Abhinavkrishna3211/Sloth-Clock/hardware/sloth_clock.pdf

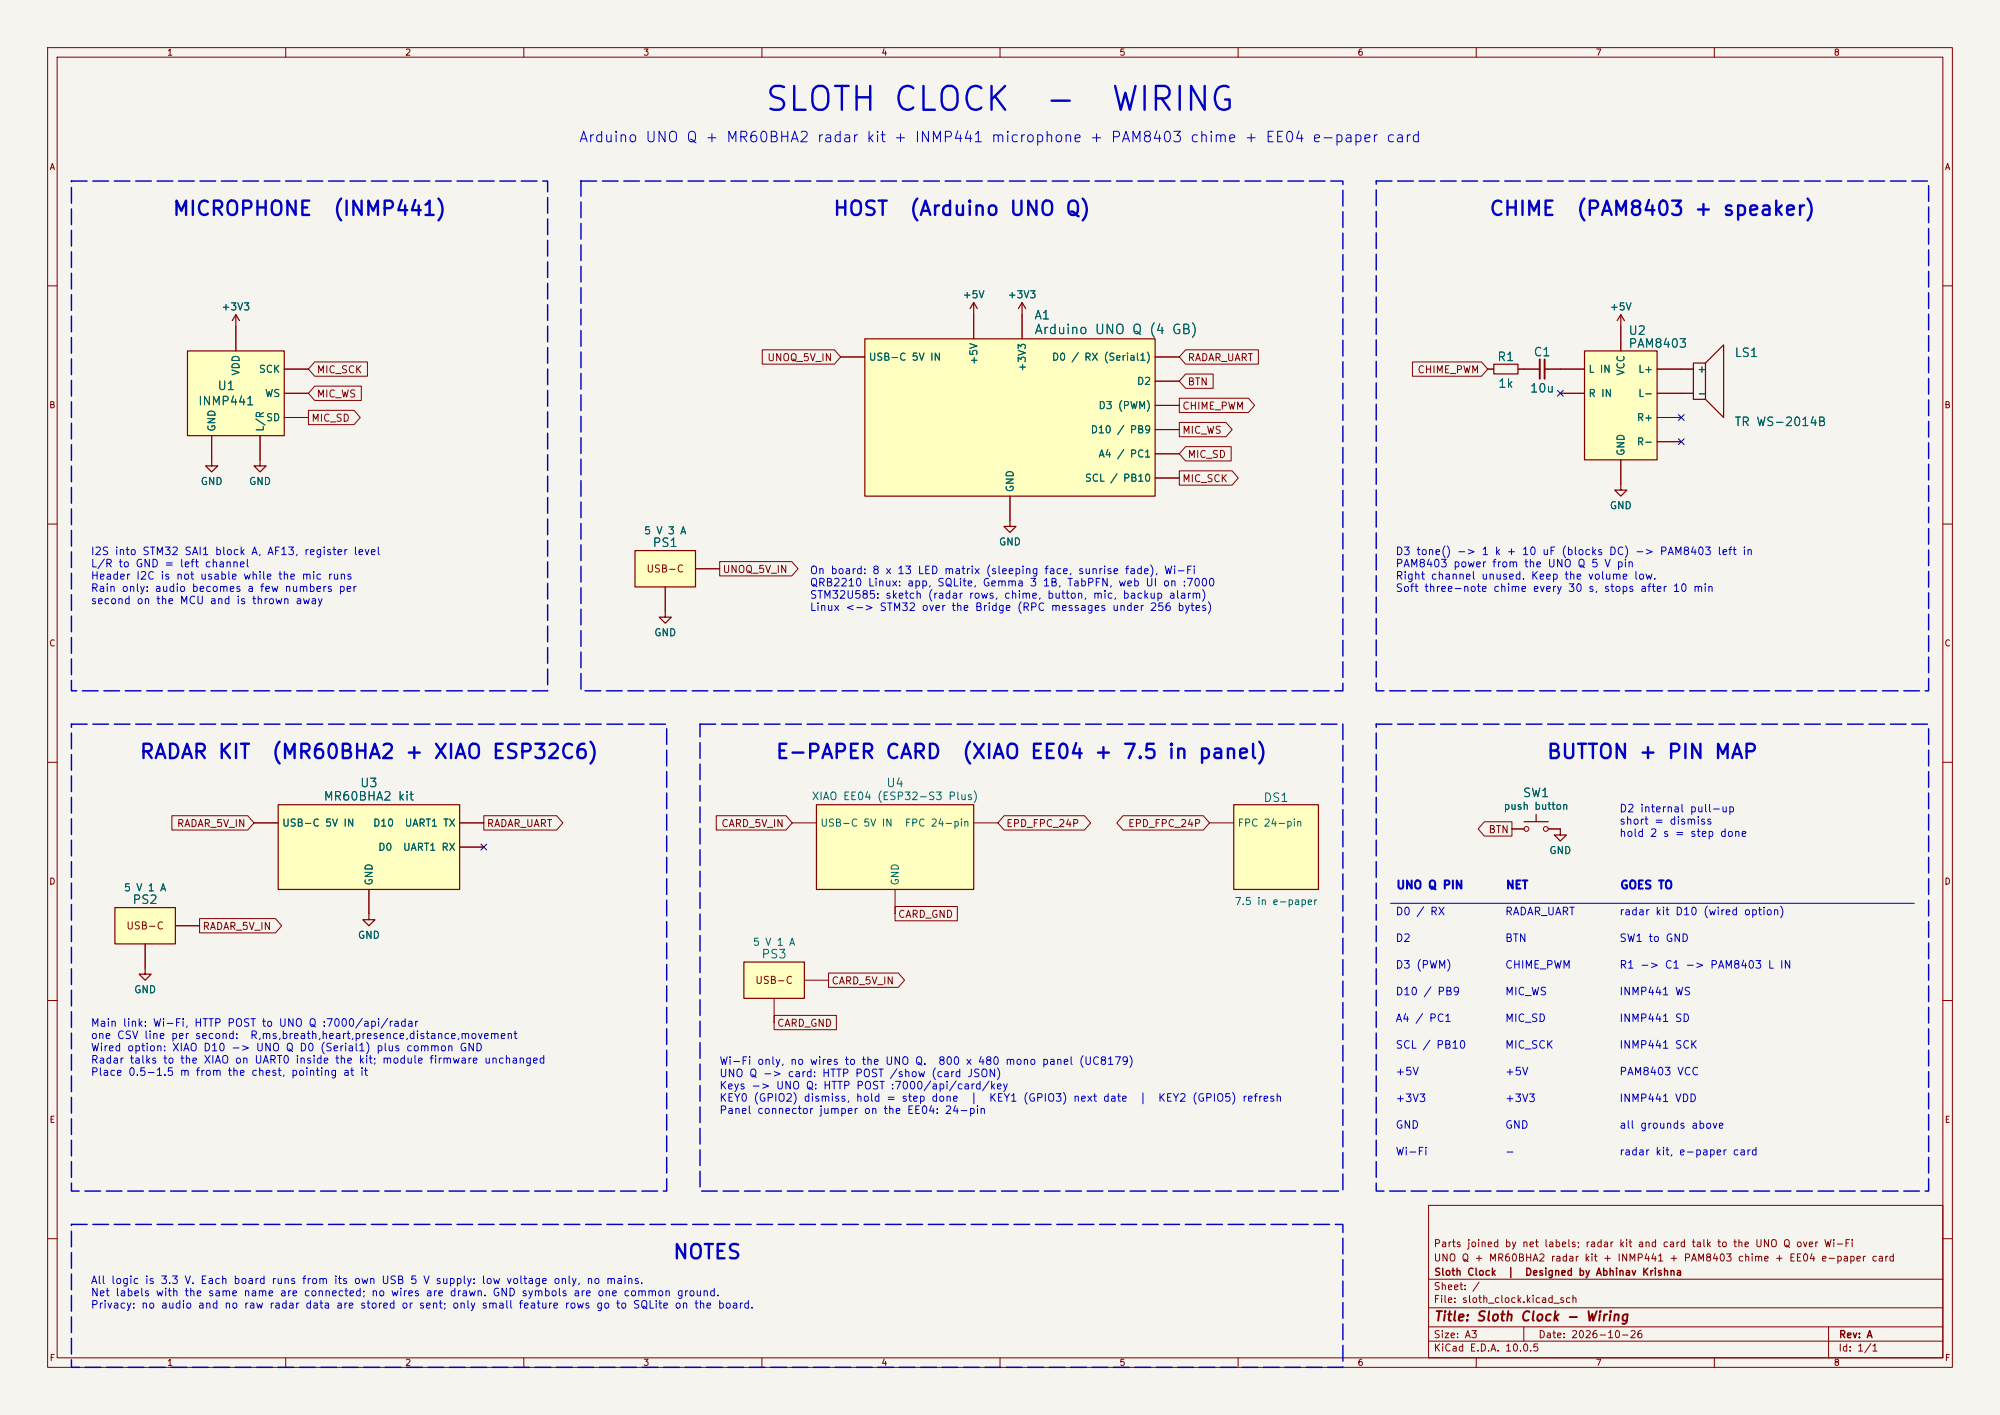
[picture p2: page 1]

Arduino UNO Q + MR60BHA2 radar kit + INMP441 microphone + PAM8403 chime + EE04 e-paper card

I2S into STM32 SAI1 block A, AF13, register level
L/R to GND = left channel
Header I2C is not usable while the mic runs Rain only: audio becomes a few numbers per

D3 tone() -> 1 k + 10 uF (blocks DC) -> PAM8403 left in
PAM8403 power from the UNO Q 5 V pin
Right channel unused. Keep the volume low.
Soft three-note chime every 30 s, stops after 10 min

On board: 8 x 13 LED matrix (sleeping face, sunrise fade), Wi-Fi
QRB2210 Linux: app, SQLite, Gemma 3 1B, TabPFN, web UI on :7000
STM32U585: sketch (radar rows, chime, button, mic, backup alarm)
Linux <-> STM32 over the Bridge (RPC messages under 256 bytes)

second on the MCU and is thrown away

E-PAPER CARD (XIAO EE04 + 7.5 in panel)

USB-C 5V IN FPC 24-pin GND

radar kit D10 (wired option)

Wired option: XIAO D10 -> UNO Q D0 (Serial1) plus common GND
Radar talks to the XIAO on UART0 inside the kit; module firmware unchanged
Place 0.5-1.5 m from the chest, pointing at it

UNO Q -> card: HTTP POST /show (card JSON)
Keys -> UNO Q: HTTP POST :7000/api/card/key
Panel connector jumper on the EE04: 24-pin

Parts joined by net labels; radar kit and card talk to the UNO Q over Wi-Fi
UNO Q + MR60BHA2 radar kit + INMP441 + PAM8403 chime + EE04 e-paper card
Sloth Clock | Designed by Abhinav Krishna
Sheet: /
File: sloth_clock.kicad_sch
Title: Sloth Clock - Wiring

All logic is 3.3 V. Each board runs from its own USB 5 V supply: low voltage only, no mains.
Net labels with the same name are connected; no wires are drawn. GND symbols are one common ground.
Privacy: no audio and no raw radar data are stored or sent; only small feature rows go to SQLite on the board.

Size: A3 | Rev: A | F Date: 2026-10-26
KiCad E.D.A. 10.0.5 | Id: 1/1
