Abhinavkrishna3211/Sloth-Clock/hardware/sloth_clock.kicad_sch

## KiCad design hardware/sloth_clock.kicad_sch (2026-10-26)

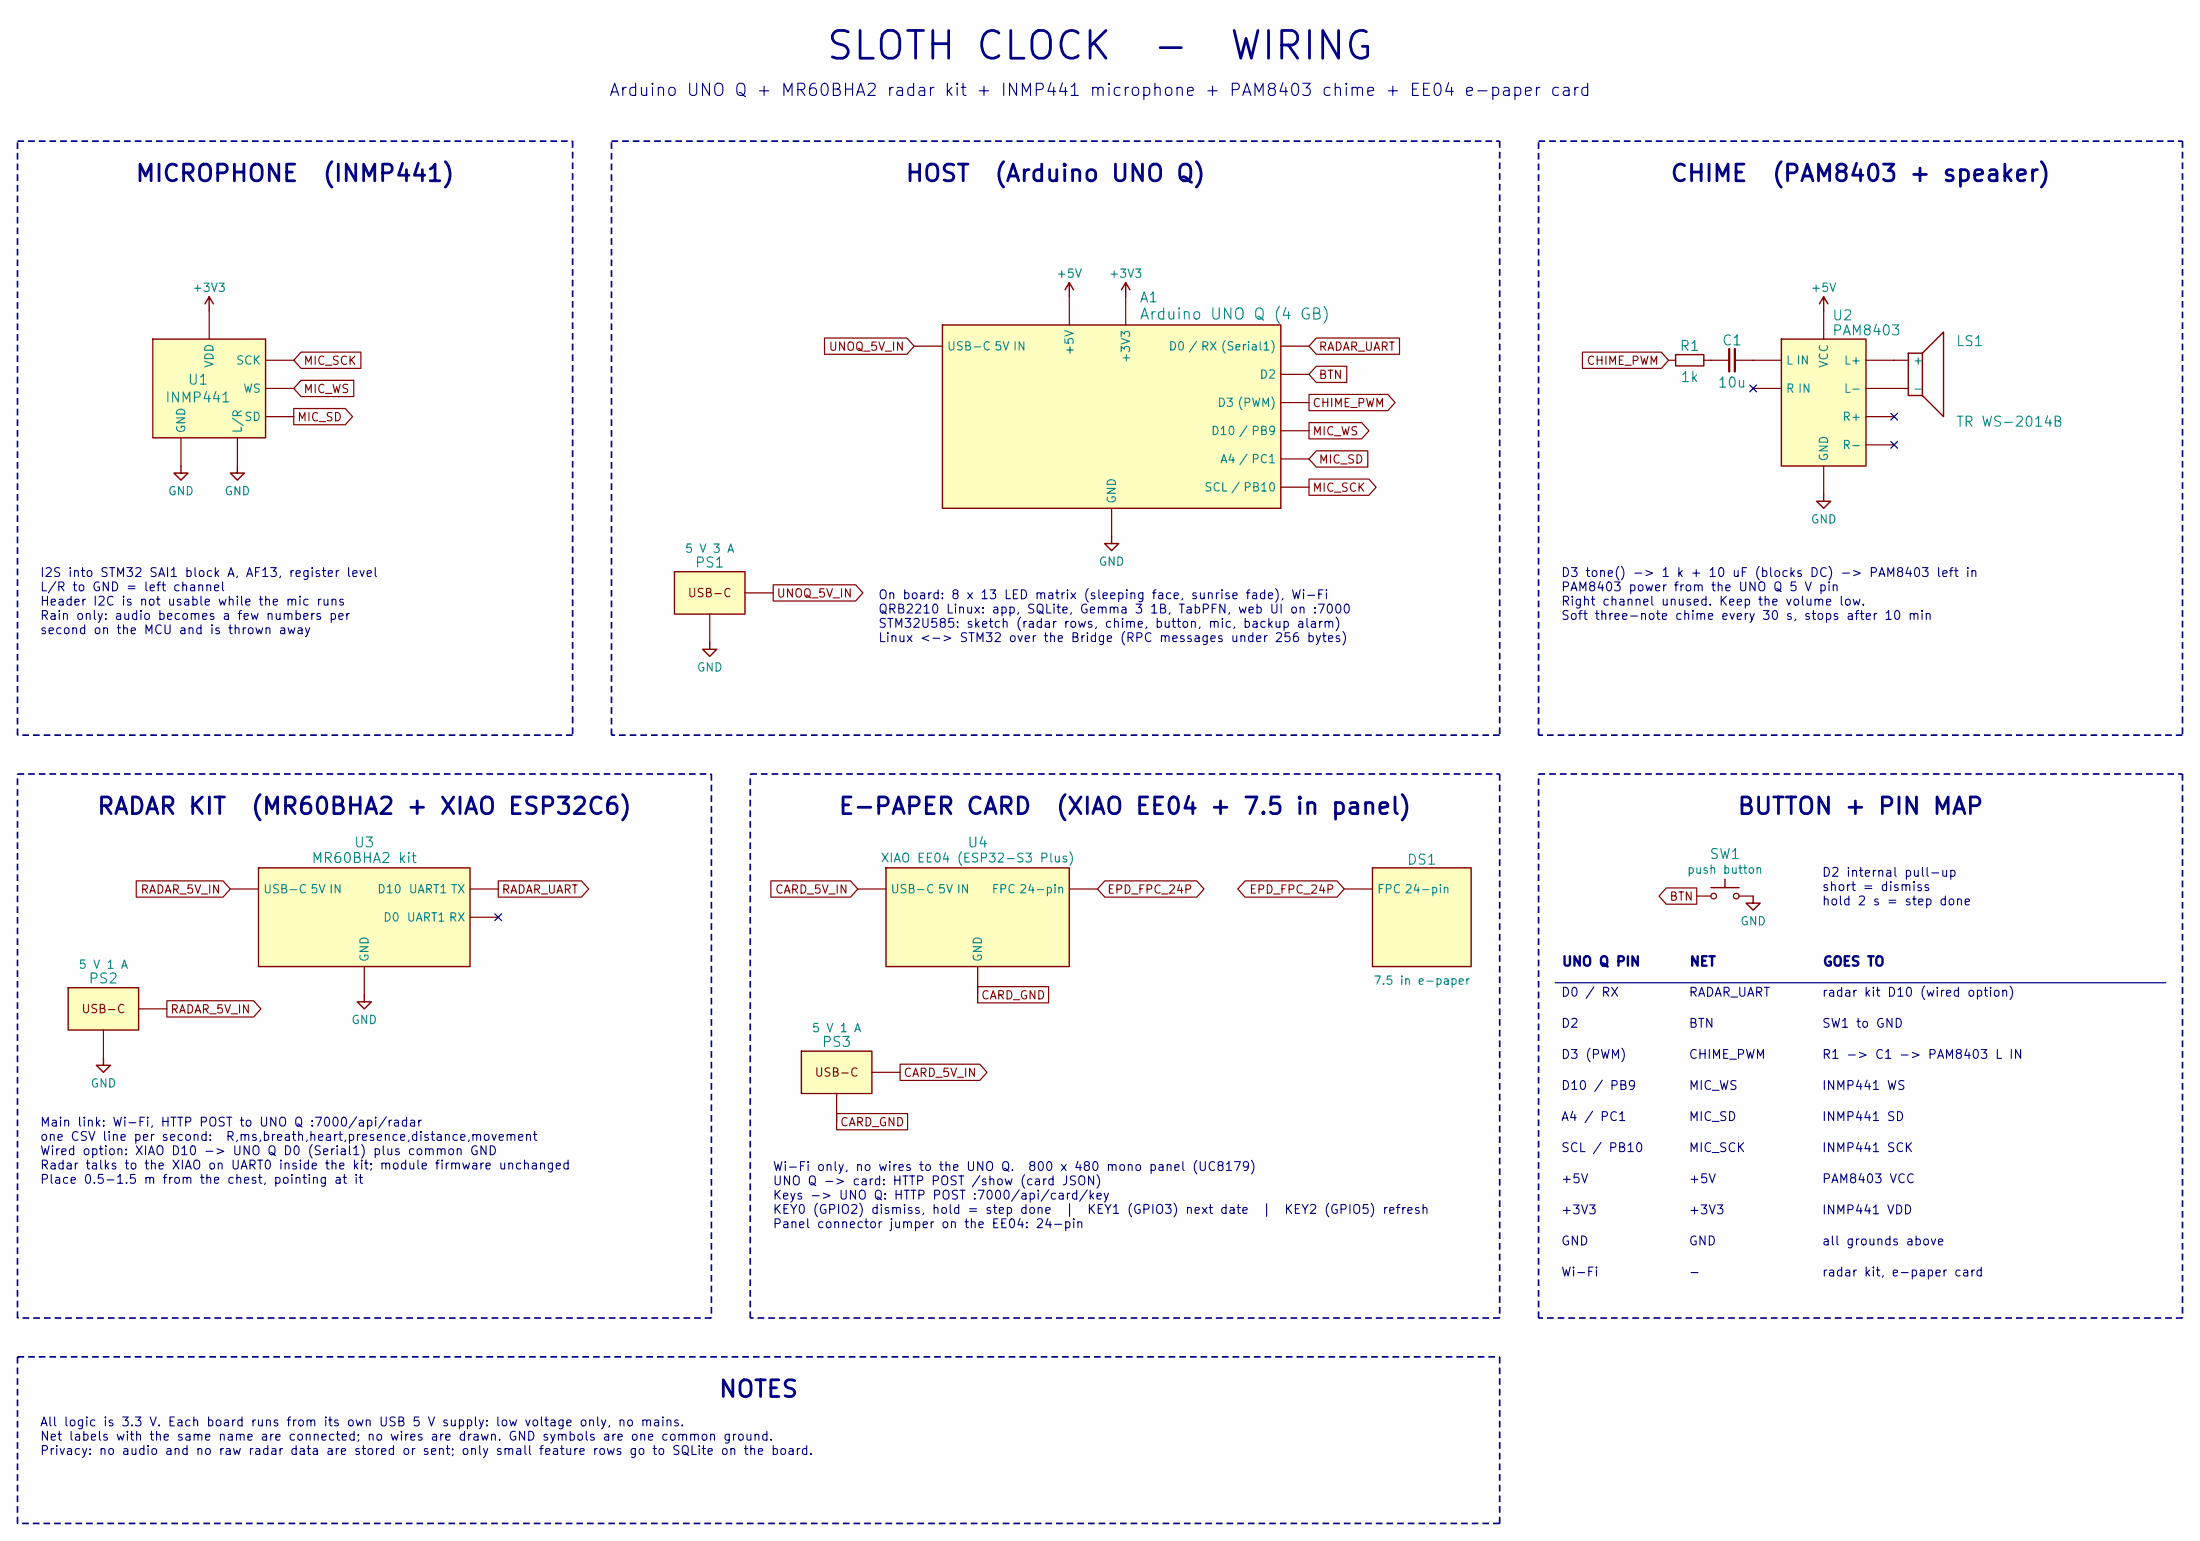
[picture p3: schematic sloth_clock.kicad_sch]

Parts:
A1: Arduino UNO Q (4 GB)
C1: 10u
DS1: 7.5 in e-paper
LS1: TR WS-2014B
PS1: 5 V 3 A
PS2, PS3: 5 V 1 A
R1: 1k
SW1: push button
U1: INMP441
U2: PAM8403
U3: MR60BHA2 kit
U4: XIAO EE04 (ESP32-S3 Plus)

Connections:
+3V3: A1.9 (+3V3), U1.4 (VDD)
+5V: A1.8 (+5V), U2.7 (VCC)
BTN: A1.3 (D2), SW1.1
CARD_5V_IN: PS3.1 (5V), U4.1 (USB-C 5V IN)
CARD_GND: PS3.2 (GND), U4.3 (GND)
CHIME_PWM: A1.4 (D3 (PWM)), R1.1
EPD_FPC_24P: DS1.1, U4.2 (FPC 24-pin)
GND: A1.10 (GND), PS1.2 (GND), PS2.2 (GND), SW1.2, U1.5 (GND), U1.6 (L/R), U2.8 (GND), U3.4 (GND)
MIC_SCK: A1.7 (SCL / PB10), U1.1 (SCK)
MIC_SD: A1.6 (A4 / PC1), U1.3 (SD)
MIC_WS: A1.5 (D10 / PB9), U1.2 (WS)
unnamed: C1.1, R1.2
unnamed: C1.2, U2.1 (L IN)
unnamed: LS1.1 (+), U2.3 (L+)
unnamed: LS1.2 (-), U2.4 (L-)
RADAR_5V_IN: PS2.1 (5V), U3.1 (USB-C 5V IN)
RADAR_UART: A1.2 (D0 / RX (Serial1)), U3.2 (D10 UART1 TX)
UNOQ_5V_IN: A1.1 (USB-C 5V IN), PS1.1 (5V)

Notes on the sheet:
SLOTH CLOCK - WIRING
Arduino UNO Q + MR60BHA2 radar kit + INMP441 microphone + PAM8403 chime + EE04 e-paper card
HOST (Arduino UNO Q)
On board: 8 x 13 LED matrix (sleeping face, sunrise fade), Wi-Fi QRB2210 Linux: app, SQLite, Gemma 3 1B, TabPFN, web UI on :7000 STM32U585: sketch (radar rows, chime, button, mic, backup alarm) Linux <-> STM32 over the Bridge (RPC messages under 256 bytes)
MICROPHONE (INMP441)
I2S into STM32 SAI1 block A, AF13, register level L/R to GND = left channel Header I2C is not usable while the mic runs Rain only: audio becomes a few numbers per second on the MCU and is thrown away
CHIME (PAM8403 + speaker)
D3 tone() -> 1 k + 10 uF (blocks DC) -> PAM8403 left in PAM8403 power from the UNO Q 5 V pin Right channel unused. Keep the volume low. Soft three-note chime every 30 s, stops after 10 min
RADAR KIT (MR60BHA2 + XIAO ESP32C6)
Main link: Wi-Fi, HTTP POST to UNO Q :7000/api/radar one CSV line per second: R,ms,breath,heart,presence,distance,movement Wired option: XIAO D10 -> UNO Q D0 (Serial1) plus common GND Radar talks to the XIAO on UART0 inside the kit; module firmware unchanged Place 0.5-1.5 m from the chest, pointing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
E-PAPER CARD (XIAO EE04 + 7.5 in panel)
Wi-Fi only, no wires to the UNO Q. 800 x 480 mono panel (UC8179) UNO Q -> card: HTTP POST /show (card JSON) Keys -> UNO Q: HTTP POST :7000/api/card/key KEY0 (GPIO2) dismiss, hold = step done | KEY1 (GPIO3) next date | KEY2 (GPIO5) refresh Panel connector jumper on the EE04: 24-pin
BUTTON + PIN MAP
D2 internal pull-up short = dismiss hold 2 s = step done
UNO Q PIN
NET
GOES TO
D0 / RX
RADAR_UART
radar kit D10 (wired option)
BTN
SW1 to GND
D3 (PWM)
CHIME_PWM
R1 -> C1 -> PAM8403 L IN
D10 / PB9
MIC_WS
INMP441 WS
A4 / PC1
MIC_SD
INMP441 SD
SCL / PB10
MIC_SCK
INMP441 SCK
+5V
PAM8403 VCC
+3V3
INMP441 VDD
GND
all grounds above
Wi-Fi
radar kit, e-paper card
NOTES
All logic is 3.3 V. Each board runs from its own USB 5 V supply: low voltage only, no mains. Net labels with the same name are connected; no wires are drawn. GND symbols are one common ground. Privacy: no audio and no raw radar data are stored or sent; only small feature rows go to SQLite on the bo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
