Abhinavkrishna3211/Sloth-Clock/(commit log)

2026-10-26 Ground wake messages in code-built reasons; add validator rules, boot service, measurements
2026-10-26 Add backup alarm, tiny-step engine, rain features and e-paper card
    Sketch: MCU backup alarm and SAI1 microphone features (link step still
    failing on the board, under investigation).
    App: dates and jobs with step splitting, size predictor, rain detection,
    card push and key handling, web UI sections.
    Firmware: EE04 e-paper card renderer (not yet flashed).
    Tests for countdowns, step checks, size choice and the rain rule.
    [epaper_card.ino, sketch.ino]
2026-10-26 Fix sketch build: rename register constants, provide __errno for libm
    [sketch.ino]
2026-10-26 Final polish and bug fixes
    - Polish step size choice: TabPFN when installed, logistic regression otherwise
    - Fix e-paper card text (plain ASCII) and report its refresh time
    - Polish the wake alarm: smoother sunrise on the LED matrix, clearer repeating chime
    - Fix radar forwarder build (serial port name clash)
    - Polish docs: wiring schematic, README, measurements and progress
    - Fix test benches for T6/T7
    - Ignore media folder
    [sloth_clock.kicad_sch]
